christiansassi/embedded-project/assets/images/connection diagrams/esp32-vl53lxx-v2.png

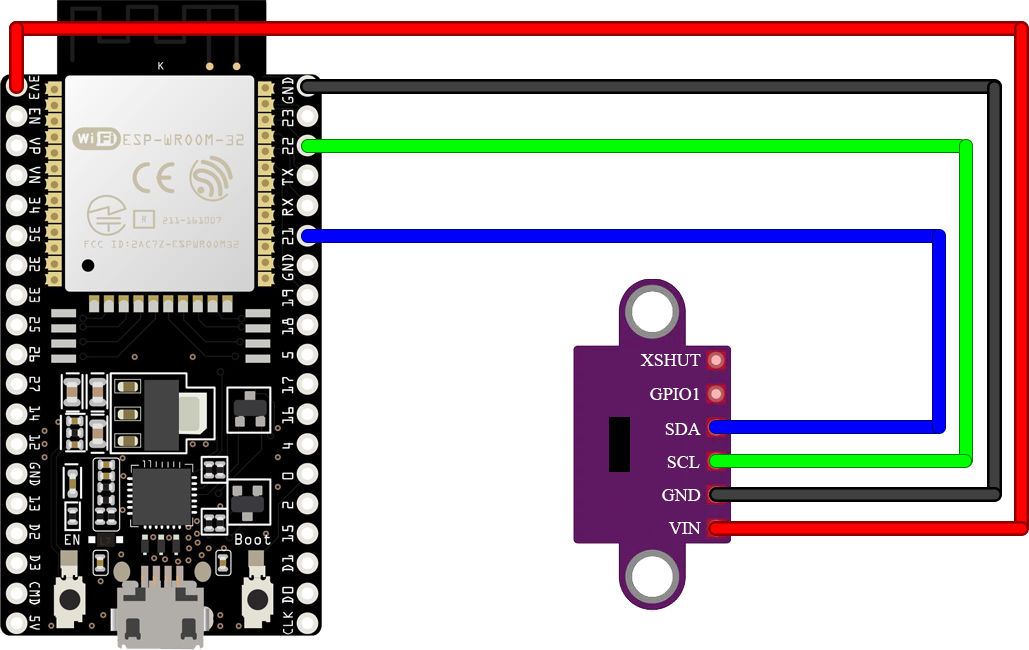
assets/images/connection diagrams/esp32-vl53lxx-v2.png
