christiansassi/embedded-project/assets/images/connection diagrams/msp432-encoder.png

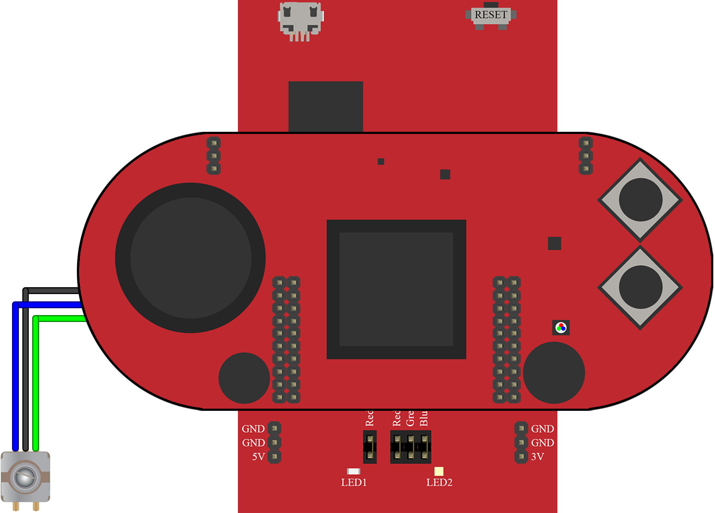
assets/images/connection diagrams/msp432-encoder.png
