christiansassi/embedded-project/(list of files, cad)

Other CAD files:
MSP432P401R/src/Debug/LcdDriver/HAL_I2C.obj
MSP432P401R/src/Debug/LcdDriver/HAL_MSP_EXP432P401R_Crystalfontz128x128_ST7735.obj
MSP432P401R/src/Debug/LcdDriver/Crystalfontz128x128_ST7735.obj
MSP432P401R/src/Debug/LcdDriver/HAL_TMP006.obj
MSP432P401R/src/Debug/LcdDriver/HAL_OPT3001.obj
