christiansassi/embedded-project/MSP432P401R/src/Gr_meter.c

#include <ti/grlib/grlib.h>


static const unsigned char pixel_meter4BPP_UNCOMP[] =
{
0x00, 0x00, 0x00, 0x00, 0x00, 0x00, 0x00, 0x00, 0x00, 0x00, 0x00, 0x00, 0x00, 0x00, 0x00, 0x00, 0x00, 0x00, 0x00, 0x00, 0x00, 0x00, 0x00, 0x00, 0x00, 0x00, 0x00, 0x00, 0x00, 0x00, 0x00, 0x00, 0x00, 0x00, 0x00, 0x00, 0x00, 0x00, 0x00, 0x00, 0x00, 0x00, 0x00, 0x00, 0x00, 0x00, 0x00, 0x00, 0x00, 0x00, 0x00, 0x00, 0x00, 0x00, 0x00, 0x00, 0x00, 0x00, 0x00, 0x00, 0x00, 0x00, 0x00, 0x00,
0xd0, 0xd0, 0xd0, 0xd0, 0xd0, 0xd0, 0xd0, 0xd0, 0xd0, 0xd0, 0xd0, 0xd0, 0xd0, 0xd0, 0xd0, 0xd0, 0xd0, 0xd0, 0xd0, 0xd0, 0xd0, 0xd0, 0xd0, 0xd0, 0xd0, 0xd0, 0xd0, 0xd0, 0xd0, 0xd0, 0xd0, 0xd0, 0xd0, 0xd0, 0xd0, 0xd0, 0xd0, 0xd0, 0xd0, 0xd0, 0xd0, 0xd0, 0xd0, 0xd0, 0xd0, 0xd0, 0xd0, 0xd0, 0xd0, 0xd0, 0xd0, 0xd0, 0xd0, 0xd0, 0xd0, 0xd0, 0xd0, 0xd0, 0xd0, 0xd0, 0xd0, 0xd0, 0xd0, 0xd0,
0x0d, 0x00, 0x0d, 0x00, 0x0d, 0x00, 0x0d, 0x00, 0x0d, 0x00, 0x0d, 0x00, 0x0d, 0x00, 0x0d, 0x00, 0x0d, 0x00, 0x0d, 0x00, 0x0d, 0x00, 0x0d, 0x00, 0x0d, 0x00, 0x0d, 0x00, 0x0d, 0x00, 0x0d, 0x00, 0x0d, 0x00, 0x0d, 0x00, 0x0d, 0x00, 0x0d, 0x00, 0x0d, 0x00, 0x0d, 0x00, 0x0d, 0x00, 0x0d, 0x00, 0x0d, 0x00, 0x0d, 0x00, 0x0d, 0x00, 0x0d, 0x00, 0x0d, 0x00, 0x0d, 0x00, 0x0d, 0x00, 0x0d, 0x00,
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
    0xc4151a,   0xfc0405,   0x000506,   0x070005,
    0xf5090b,   0x0b0001,   0xfb0200,   0xffffff
};

const tImage  meter4BPP_UNCOMP=
{
    IMAGE_FMT_4BPP_UNCOMP,
    128,
    128,
    16,
    palette_meter4BPP_UNCOMP,
    pixel_meter4BPP_UNCOMP,
};
