christiansassi/embedded-project/MSP432P401R/src/Gr_menu.c

#include <ti/grlib/grlib.h>

static const unsigned char pixel_menu4BPP_UNCOMP[] =
{
 0xb0, 0xb0, 0xb0, 0xb0, 0xb0, 0xb0, 0xb0, 0xb0, 0xb0, 0xb0, 0xb0, 0xb0, 0xb0, 0xb0, 0xb0, 0xb0, 0xb0, 0xb0, 0xb0, 0xb0, 0xb0, 0xb0, 0xb0, 0xb0, 0xb0, 0xb0, 0xb0, 0xb0, 0xb0, 0xb0, 0xb0, 0xb0, 0xb0, 0xb0, 0xb0, 0xb0, 0xb0, 0xb0, 0xb0, 0xb0, 0xb0, 0xb0, 0xb0, 0xb0, 0xb0, 0xb0, 0xb0, 0xb0, 0xb0, 0xb0, 0xb0, 0xb0, 0xb0, 0xb0, 0xb0, 0xb0, 0xb0, 0xb0, 0xb0, 0xb0, 0xb0, 0xb0, 0xb0, 0xb0,
 0x0b, 0x00, 0x0b, 0x00, 0x0b, 0x00, 0x0b, 0x00, 0x0b, 0x00, 0x0b, 0x00, 0x0b, 0x00, 0x0b, 0x00, 0x0b, 0x00, 0x0b, 0x00, 0x0b, 0x00, 0x0b, 0x00, 0x0b, 0x00, 0x0b, 0x00, 0x0b, 0x00, 0x0b, 0x00, 0x0b, 0x00, 0x0b, 0x00, 0x0b, 0x00, 0x0b, 0x00, 0x0b, 0x00, 0x0b, 0x00, 0x0b, 0x00, 0x0b, 0x00, 0x0b, 0x00, 0x0b, 0x00, 0x0b, 0x00, 0x0b, 0x00, 0x0b, 0x00, 0x0b, 0x00, 0x0b, 0x00, 0x0b, 0x00,
 0xb0, 0xb0, 0xb0, 0xb0, 0xb0, 0xb0, 0xb0, 0xb0, 0xb0, 0xb0, 0xb0, 0xb0, 0xb0, 0xb0, 0xb0, 0xb0, 0xb0, 0xb0, 0xb0, 0xb0, 0xb0, 0xb0, 0xb0, 0xb0, 0xb0, 0xb0, 0xb0, 0xb0, 0xb0, 0xb0, 0xb0, 0xb0, 0xb0, 0xb0, 0xb0, 0xb0, 0xb0, 0xb0, 0xb0, 0xb0, 0xb0, 0xb0, 0xb0, 0xb0, 0xb0, 0xb0, 0xb0, 0xb0, 0xb0, 0xb0, 0xb0, 0xb0, 0xb0, 0xb0, 0xb0, 0xb0, 0xb0, 0xb0, 0xb0, 0xb0, 0xb0, 0xb0, 0xb0, 0xb0,
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
 0xb51b23,   0x000007,   0xa6100f,   0x030004,
 0xa61011,   0x000303,   0xca191f,   0x00000a,
 0x910609,   0xfc0300,   0x000105,   0xffffff
};

const tImage  menu4BPP_UNCOMP=
{
    IMAGE_FMT_4BPP_UNCOMP,
    128,
    128,
    16,
    palette_menu4BPP_UNCOMP,
    pixel_menu4BPP_UNCOMP,
};
