christiansassi/embedded-project/MSP432P401R/src/Gr_lidar.c

#include <ti/grlib/grlib.h>

static const unsigned char pixel_lidar4BPP_UNCOMP[] =
{
0x40, 0x40, 0x40, 0x40, 0x40, 0x40, 0x40, 0x40, 0x40, 0x40, 0x40, 0x40, 0x40, 0x40, 0x40, 0x40, 0x40, 0x40, 0x40, 0x40, 0x40, 0x40, 0x40, 0x40, 0x40, 0x40, 0x40, 0x40, 0x40, 0x40, 0x40, 0x40, 0x40, 0x40, 0x40, 0x40, 0x40, 0x40, 0x40, 0x40, 0x40, 0x40, 0x40, 0x40, 0x40, 0x40, 0x40, 0x40, 0x40, 0x40, 0x40, 0x40, 0x40, 0x40, 0x40, 0x40, 0x40, 0x40, 0x40, 0x40, 0x40, 0x40, 0x40, 0x40,
0xe4, 0x90, 0xe4, 0x90, 0xe4, 0x90, 0xe4, 0x90, 0xe4, 0x90, 0xe4, 0x90, 0xe4, 0x90, 0xe4, 0x90, 0xe4, 0x90, 0xe4, 0x90, 0xe4, 0x90, 0xe4, 0x90, 0xe4, 0x90, 0xe4, 0x90, 0xe4, 0x90, 0xe4, 0x90, 0xe4, 0x90, 0xe4, 0x90, 0xe4, 0x90, 0xe4, 0x90, 0xe4, 0x90, 0xe4, 0x90, 0xe4, 0x90, 0xe4, 0x90, 0xe4, 0x90, 0xe4, 0x90, 0xe4, 0x90, 0xe4, 0x90, 0xe4, 0x90, 0xe4, 0x90, 0xe4, 0x90, 0xe4, 0x90,
0x4e, 0x40, 0x4e, 0x40, 0x4e, 0x40, 0x4e, 0x40, 0x4e, 0x40, 0x4e, 0x40, 0x4e, 0x40, 0x4e, 0x40, 0x4e, 0x40, 0x4e, 0x40, 0x4e, 0x40, 0x4e, 0x40, 0x4e, 0x40, 0x4e, 0x40, 0x4e, 0x40, 0x4e, 0x40, 0x4e, 0x40, 0x4e, 0x40, 0x4e, 0x40, 0x4e, 0x40, 0x4e, 0x40, 0x4e, 0x40, 0x4e, 0x40, 0x4e, 0x40, 0x4e, 0x40, 0x4e, 0x40, 0x4e, 0x40, 0x4e, 0x40, 0x4e, 0x40, 0x4e, 0x40, 0x4e, 0x40, 0x4e, 0x40,
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
    0x0b000c,   0x1b0000,   0x0b0002,   0xd21f18,
    0x010006,   0x270000,   0x0b0003,   0xffffff
};

const tImage  lidar4BPP_UNCOMP=
{
    IMAGE_FMT_4BPP_UNCOMP,
    128,
    128,
    16,
    palette_lidar4BPP_UNCOMP,
    pixel_lidar4BPP_UNCOMP,
};
