christiansassi/embedded-project/MSP432P401R/src/msp432_meter.c

#include "msp.h"
#include <ti/devices/msp432p4xx/driverlib/driverlib.h>
#include <ti/grlib/grlib.h>

#include "LcdDriver/Crystalfontz128x128_ST7735.h"
#include "LcdDriver/HAL_MSP_EXP432P401R_Crystalfontz128x128_ST7735.h"
#include "LcdDriver/HAL_I2C.h"
#include "LcdDriver/HAL_TMP006.h"

#include <stdio.h>

#include "msp432_meter.h"
#include "msp432_utils.h"
#include "msp432_init.h"
#include "msp432_uart.h"

const uint16_t wheelRadius  = 15; // Wheel radius (in millimeter)
const float pi = 3.14159265358979323846264338327950288; // Pi value

typedef enum {MENU, METER, BUBBLE_LEVEL, LIDAR} STATE;
extern volatile STATE CURRENT_STATE;


//*****************************************************************************
//
//! Prints the measurement data on the display (cm only)
//
//*****************************************************************************

void printMeasure(Graphics_Context *g_sContext, float measure)
{
    Graphics_drawStringCentered(g_sContext, (int8_t *) "         ",AUTO_STRING_LENGTH, CENTER, START_HEIGHT+27, OPAQUE_TEXT);

    char string[5]; // String to print on the display
    sprintf(string, "%.2f cm", measure/10);

    Graphics_drawStringCentered(g_sContext, (int8_t *) string,AUTO_STRING_LENGTH, CENTER, START_HEIGHT+27, OPAQUE_TEXT);
}

//*****************************************************************************
//
//! Handles encoder signals
//
//*****************************************************************************
void encoder(Graphics_Context *g_sContext)
{
    float measure = 0.0; // Distance in Millimeter

    // Define increment
    float inc = (2*pi*wheelRadius)/20; // Measure increment at each step

    drawImageMeter(g_sContext);
    printMeasure(g_sContext, measure);

    int prevClk, prevDt;

    prevClk = GPIO_getInputPinValue(portClk, pinClk);
    prevDt = GPIO_getInputPinValue(portDt, pinDt);

    int i=0;

    while(CURRENT_STATE == METER){
        // Clock and Data signal from the encoder
        int currClk = GPIO_getInputPinValue(portClk, pinClk);
        int currDt = GPIO_getInputPinValue(portDt, pinDt);

        // If the encoder has been rotated
        if (currClk != prevClk)
        {
            if (currDt == currClk)
            {
                // Clockwise means increment
                (i == 0 ? (measure += inc, i++) : (i = 0))
            }
            else
            {
                // Counterclockwise means decrement
                (i == 0 ? (measure -= inc, i++) : (i = 0));
            }

            prevClk = currClk;

            // Keep captured measure greater or equal than 0
            measure = (measure < 0) ? 0 : measure;

            printMeasure(g_sContext, measure);
        }

    }
}

//*****************************************************************************
//
//! Manages startup and shutdown of the measurement
//
//*****************************************************************************
void meter(Graphics_Context *g_sContext)
{

    //Turn on Green LED
    GPIO_setOutputHighOnPin(GPIO_PORT_P2, GPIO_PIN4);
    encoder(g_sContext);

    GPIO_setOutputLowOnPin(GPIO_PORT_P2, GPIO_PIN4);
}
